Annath/Minidrive/L_Wurth_WE-LQSH-8040.step

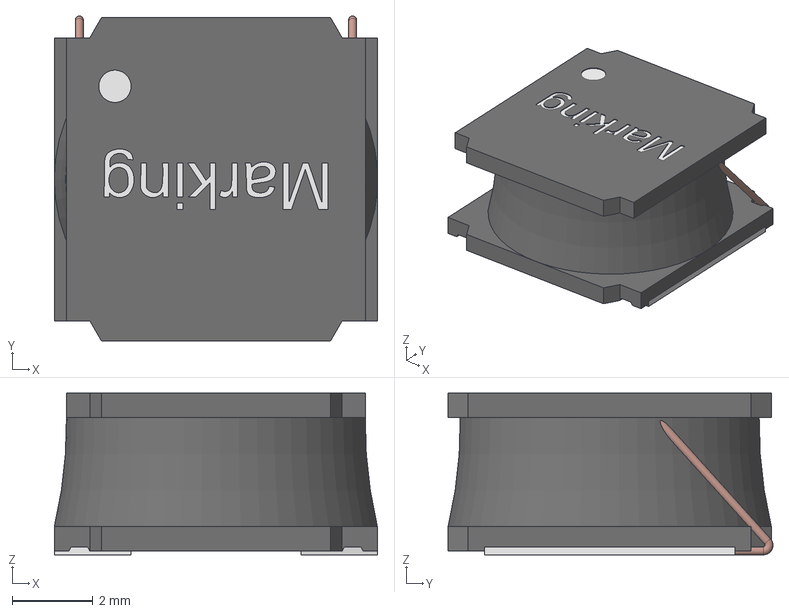
[picture p1: CAD file, 2023-09-17]
L_Wurth_WE-LQSH-8040.step
8.00 x 8.04 x 4.00 mm
