Annath/Minidrive/436500200 v3.step

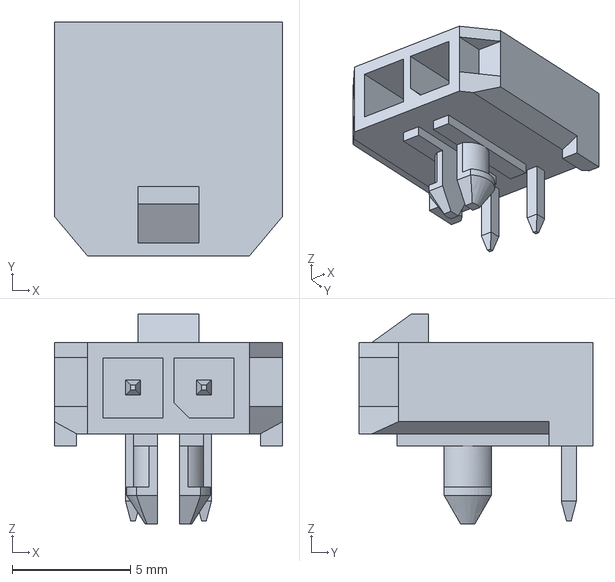
[picture p2: CAD file, 2023-09-10]
436500200 v3.step
9.65 x 9.90 x 8.87 mm
