Annath/Minidrive/MiniDrive.kicad_pcb

## KiCad design MiniDrive.kicad_pcb (2023-09-24)

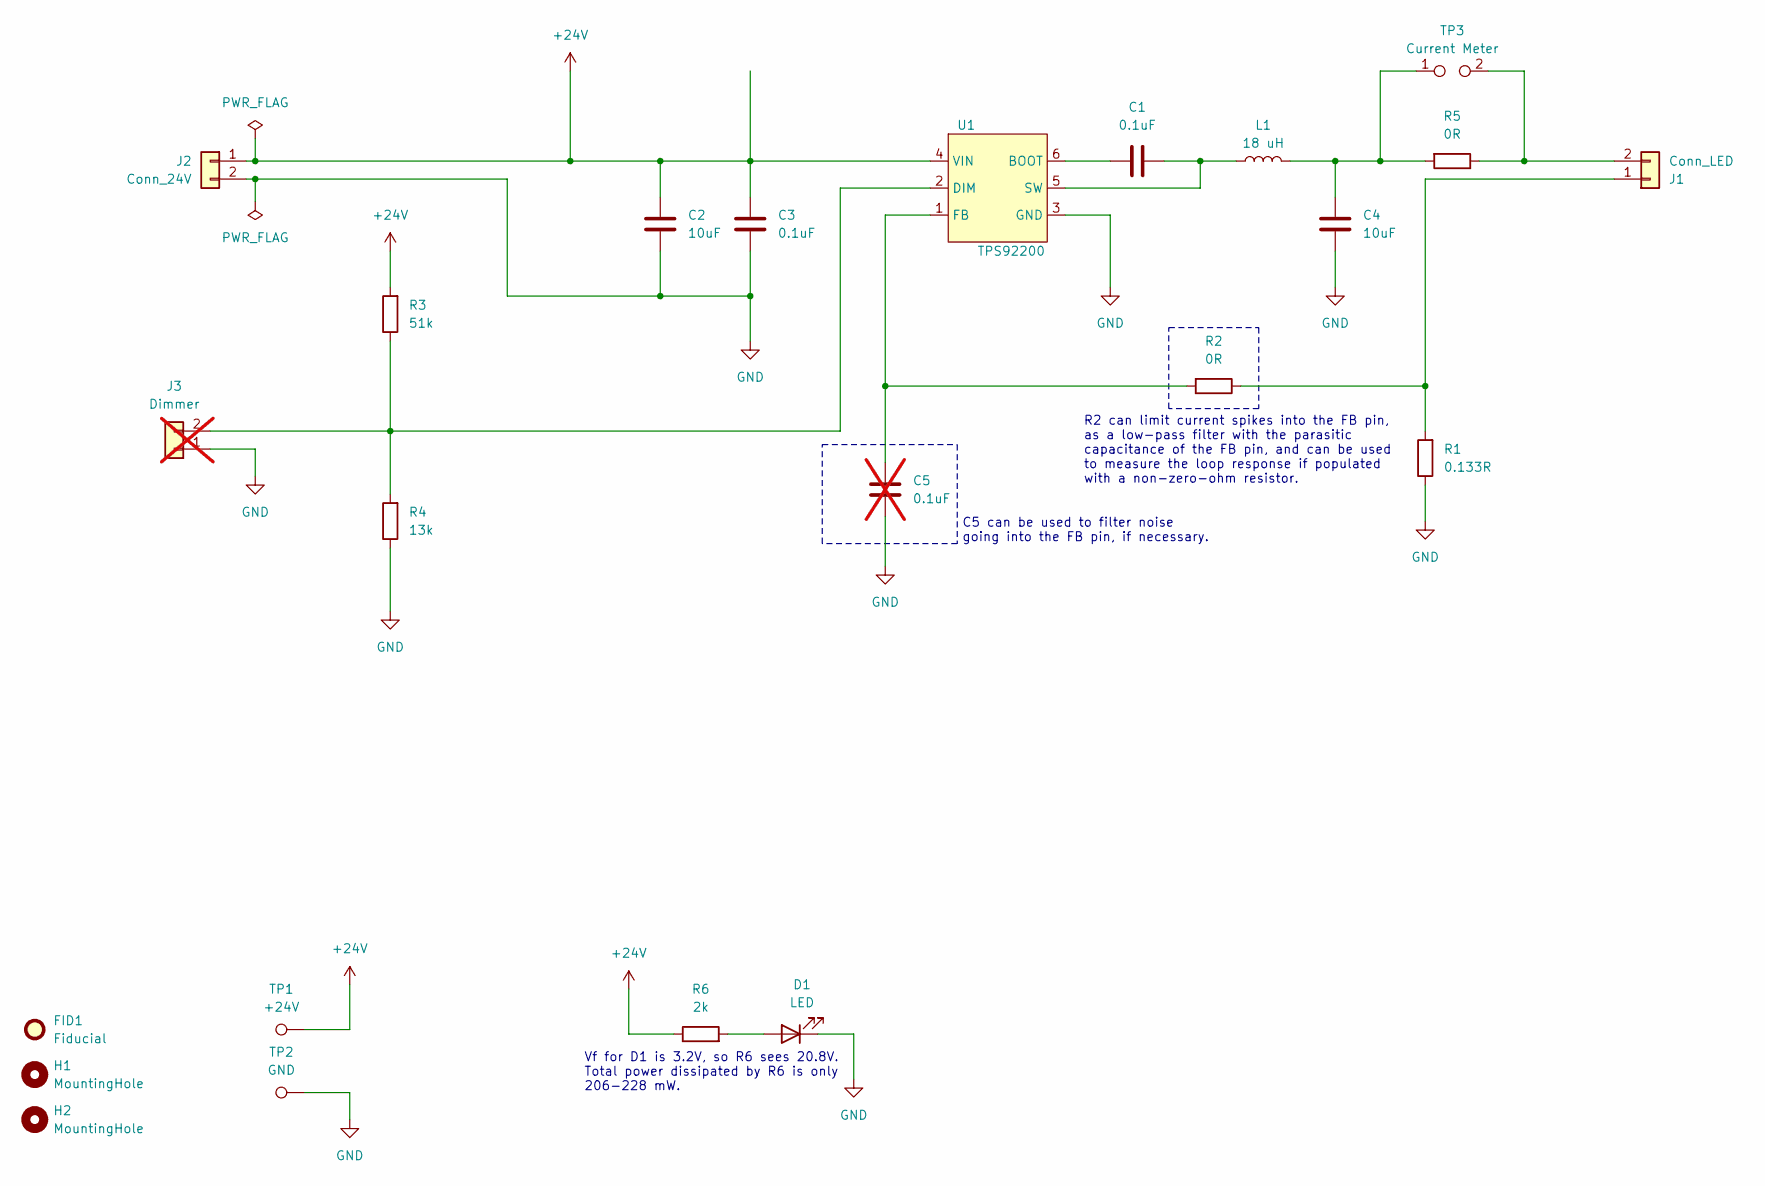
[picture p3: schematic MiniDrive.kicad_sch]

Parts:
C1, C3: 0.1uF; C_1210_3225Metric
C2, C4: 10uF; C_1206_3216Metric
C5: 0.1uF; C_0402_1005Metric; not fitted
D1: LED; LED_0603_1608Metric
FID1: Fiducial; Fiducial_0.5mm_Mask1mm
H1, H2: MountingHole; MountingHole_3.2mm_M3
J1: Conn_LED; Molex_Micro-Fit_3.0_43650-0200_1x02_P3.00mm_Horizontal
J2: Conn_24V; Molex_Micro-Fit_3.0_43650-0200_1x02_P3.00mm_Horizontal
J3: Dimmer; JST_PH_B2B-PH-K_1x02_P2.00mm_Vertical; not fitted
L1: 18 uH; L_Wurth_WE-LQS-8040
R1: 0.133R; R_1206_3216Metric
R2, R5: 0R; R_1206_3216Metric
R3: 51k; R_1206_3216Metric
R4: 13k; R_1206_3216Metric
R6: 2k; R_0805_2012Metric
TP1: +24V; TestPoint_THTPad_D1.5mm_Drill0.7mm
TP2: GND; TestPoint_THTPad_D1.5mm_Drill0.7mm
TP3: Current Meter; TestPoint_2Pads_Pitch2.54mm_Drill0.8mm
U1: TPS92200; SOT-23-6

Connections:
+24V: C2.1, C3.1, J2.1, R3.2, R6.1, TP1.1, U1.4 (VIN)
GND: C2.2, C3.2, C4.2, C5.2, D1.1 (K), J2.2, J3.1, R1.1, R4.1, TP2.1, U1.3 (GND)
unnamed: C4.1, L1.2, R5.2, TP3.1
unnamed: D1.2 (A), R6.2
unnamed: J1.1, R1.2, R2.1
unnamed: J1.2, R5.1, TP3.2
unnamed: J3.2, R3.1, R4.2, U1.2 (DIM)
unnamed: C1.2, U1.6 (BOOT)
unnamed: C5.1, R2.2, U1.1 (FB)
unnamed: C1.1, L1.1, U1.5 (SW)

Notes on the sheet:
Vf for D1 is 3.2V, so R6 sees 20.8V. Total power dissipated by R6 is only 206-228 mW.
R2 can limit current spikes into the FB pin, as a low-pass filter with the parasitic capacitance of the FB pin, and can be used to measure the loop response if populated with a non-zero-ohm resistor.
C5 can be used to filter noise going into the FB pin, if necessary.

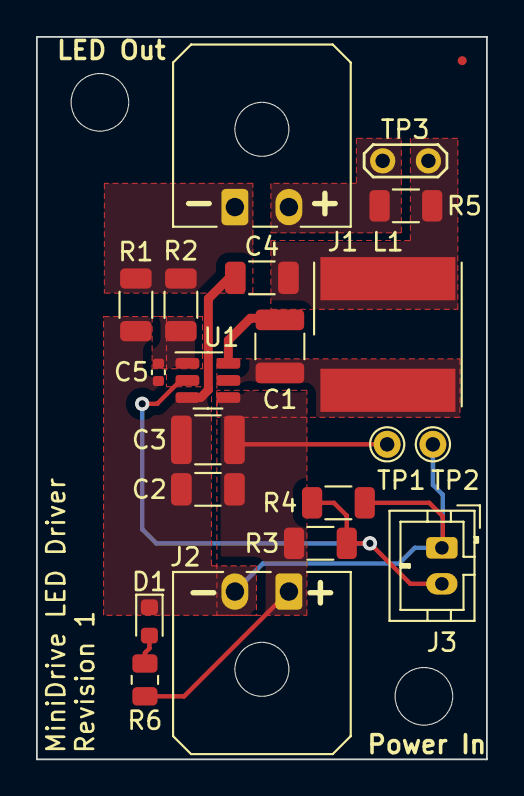
[picture p4: board MiniDrive.kicad_pcb from above]

Board: 2 copper layers, 25.0 x 40.1 mm, 23 parts (0 on the bottom side), 10 nets.
