Annath/Minidrive/LED-Driver.kicad_pcb

## KiCad design LED-Driver.kicad_pcb (2023-09-10)

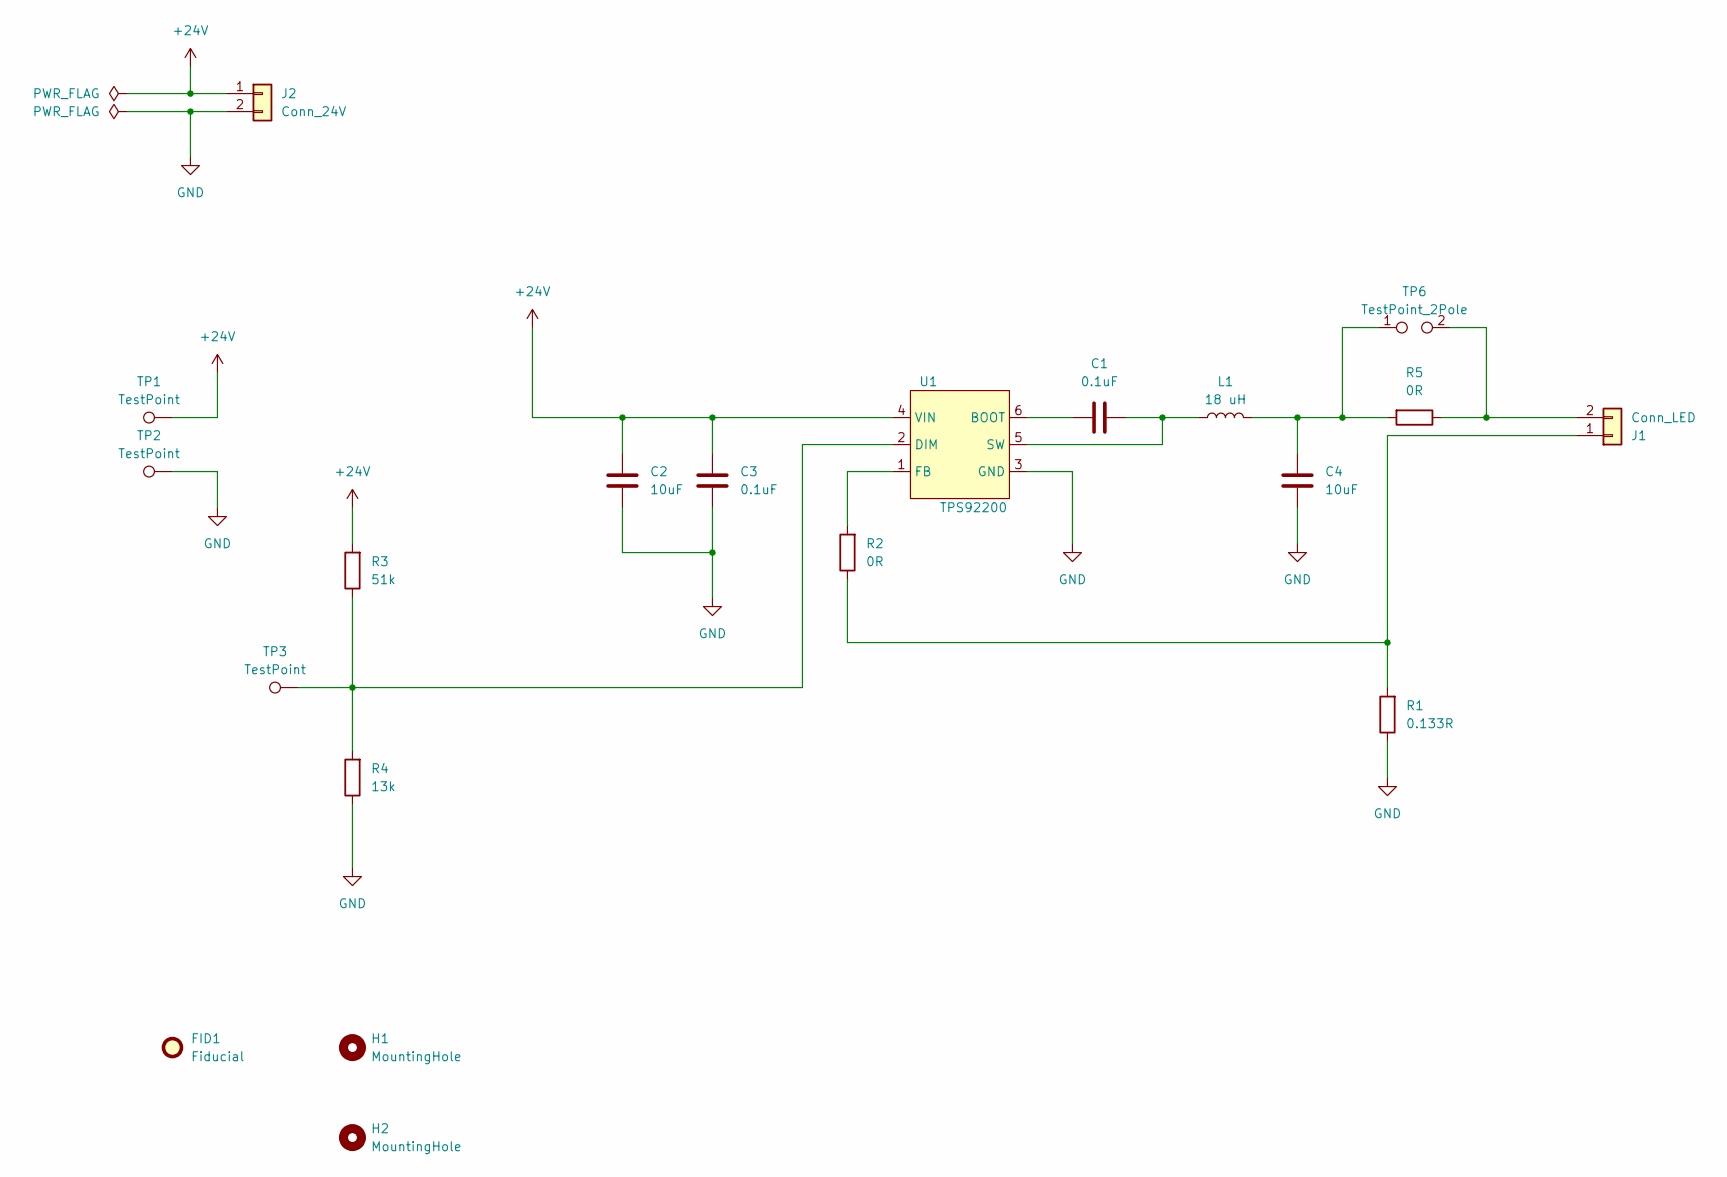
[picture p5: schematic LED-Driver.kicad_sch]

Parts:
C1, C3: 0.1uF; C_1210_3225Metric_Pad1.33x2.70mm_HandSolder
C2, C4: 10uF; C_1206_3216Metric_Pad1.33x1.80mm_HandSolder
FID1: Fiducial; Fiducial_0.5mm_Mask1mm
H1, H2: MountingHole; MountingHole_2.7mm_M2.5
J1: Conn_LED; Molex_Micro-Fit_3.0_43650-0200_1x02_P3.00mm_Horizontal
J2: Conn_24V; Molex_Micro-Fit_3.0_43650-0200_1x02_P3.00mm_Horizontal
L1: 18 uH; L_Radial_D8.7mm_P5.00mm_Fastron_07HCP
R1: 0.133R; R_1206_3216Metric_Pad1.30x1.75mm_HandSolder
R2, R5: 0R; R_1206_3216Metric_Pad1.30x1.75mm_HandSolder
R3: 51k; R_1206_3216Metric_Pad1.30x1.75mm_HandSolder
R4: 13k; R_1206_3216Metric_Pad1.30x1.75mm_HandSolder
TP1, TP2, TP3: TestPoint; TestPoint_THTPad_D1.5mm_Drill0.7mm
TP6: TestPoint_2Pole; TestPoint_2Pads_Pitch2.54mm_Drill0.8mm
U1: TPS92200; SOT-23-6_Handsoldering

Connections:
+24V: C2.1, C3.1, J2.1, R3.2, TP1.1, U1.4 (VIN)
GND: C2.2, C3.2, C4.2, J2.2, R1.1, R4.1, TP2.1, U1.3 (GND)
unnamed: C4.1, L1.2, R5.2, TP6.1
unnamed: J1.1, R1.2, R2.1
unnamed: J1.2, R5.1, TP6.2
unnamed: C1.2, U1.6 (BOOT)
unnamed: R3.1, R4.2, TP3.1, U1.2 (DIM)
unnamed: R2.2, U1.1 (FB)
unnamed: C1.1, L1.1, U1.5 (SW)

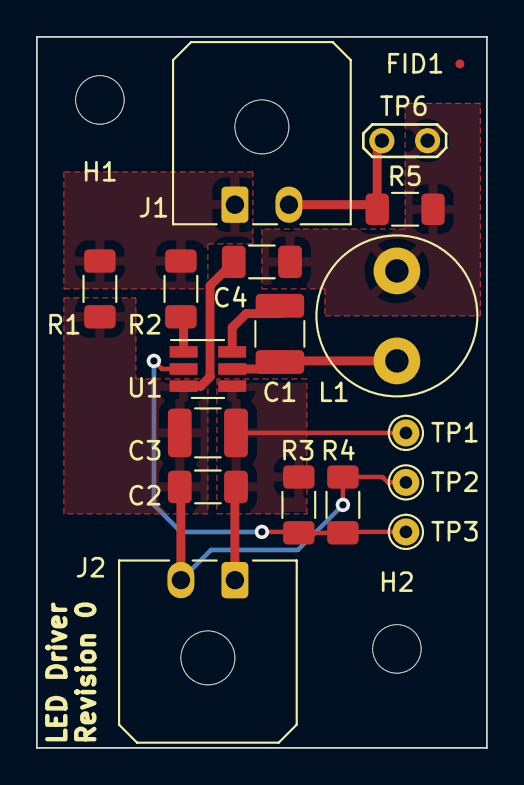
[picture p6: board LED-Driver.kicad_pcb from above]

Board: 2 copper layers, 25.0 x 39.5 mm, 20 parts (0 on the bottom side), 9 nets.
