Annath/Minidrive/(commit log)

2023-08-19 Add BOM
2023-09-10 Rough draft
    [LED-Driver.kicad_pcb, LED-Driver.kicad_sch]
2023-09-10 Minor layout improvements
    [436500200 v3.step, MiniDrive.kicad_pcb, MiniDrive.kicad_sch]
2023-09-10 BOM updated with correct parts
2023-09-10 Fixed indentation in BOM
2023-09-10 Add some in-schematic documentation as well as a DNP filter cap for FB
    [MiniDrive.kicad_sch]
2023-09-10 Fix R2 rotation
    [MiniDrive.kicad_sch]
2023-09-10 Add C5 to layout
    [MiniDrive.kicad_pcb, MiniDrive.kicad_sch]
2023-09-10 Change filled zones to solid connections
    [MiniDrive.kicad_pcb]
2023-09-14 Add custom inductor footprint
2023-09-14 Change inductor to SMT
    [MiniDrive.kicad_pcb, MiniDrive.kicad_sch]
2023-09-14 Update BOM
2023-09-14 Add power LED
    [MiniDrive.kicad_pcb, MiniDrive.kicad_sch]
2023-09-14 Add off-board dimming connector
    [MiniDrive.kicad_pcb, MiniDrive.kicad_sch]
2023-09-17 Change mounting holes to M3
    [MiniDrive.kicad_pcb, MiniDrive.kicad_sch]
2023-09-17 Update 3D model for 8040 inductor
    [L_Wurth_WE-LQSH-8040.step, MiniDrive.kicad_pcb]
2023-09-23 Clean up schematic and layout
    [MiniDrive.kicad_pcb, MiniDrive.kicad_sch]
2023-09-23 Revert back to 1206 resistors
    [MiniDrive.kicad_pcb, MiniDrive.kicad_sch]
2023-09-24 Minor tweaks, remove F1
    [MiniDrive.kicad_pcb, MiniDrive.kicad_sch]
2024-02-20 Remove unused wire
    [MiniDrive.kicad_sch]
